AlternatorRegulator/VSR-CAD/AltReg-CAN.jpg

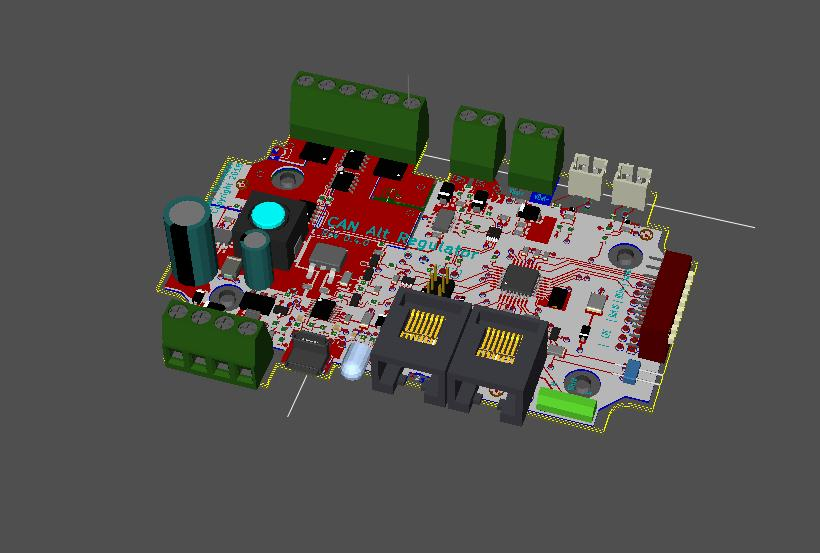
AltReg-CAN.jpg
