AlternatorRegulator/VSR-CAD/Printing Print Schematic.pdf

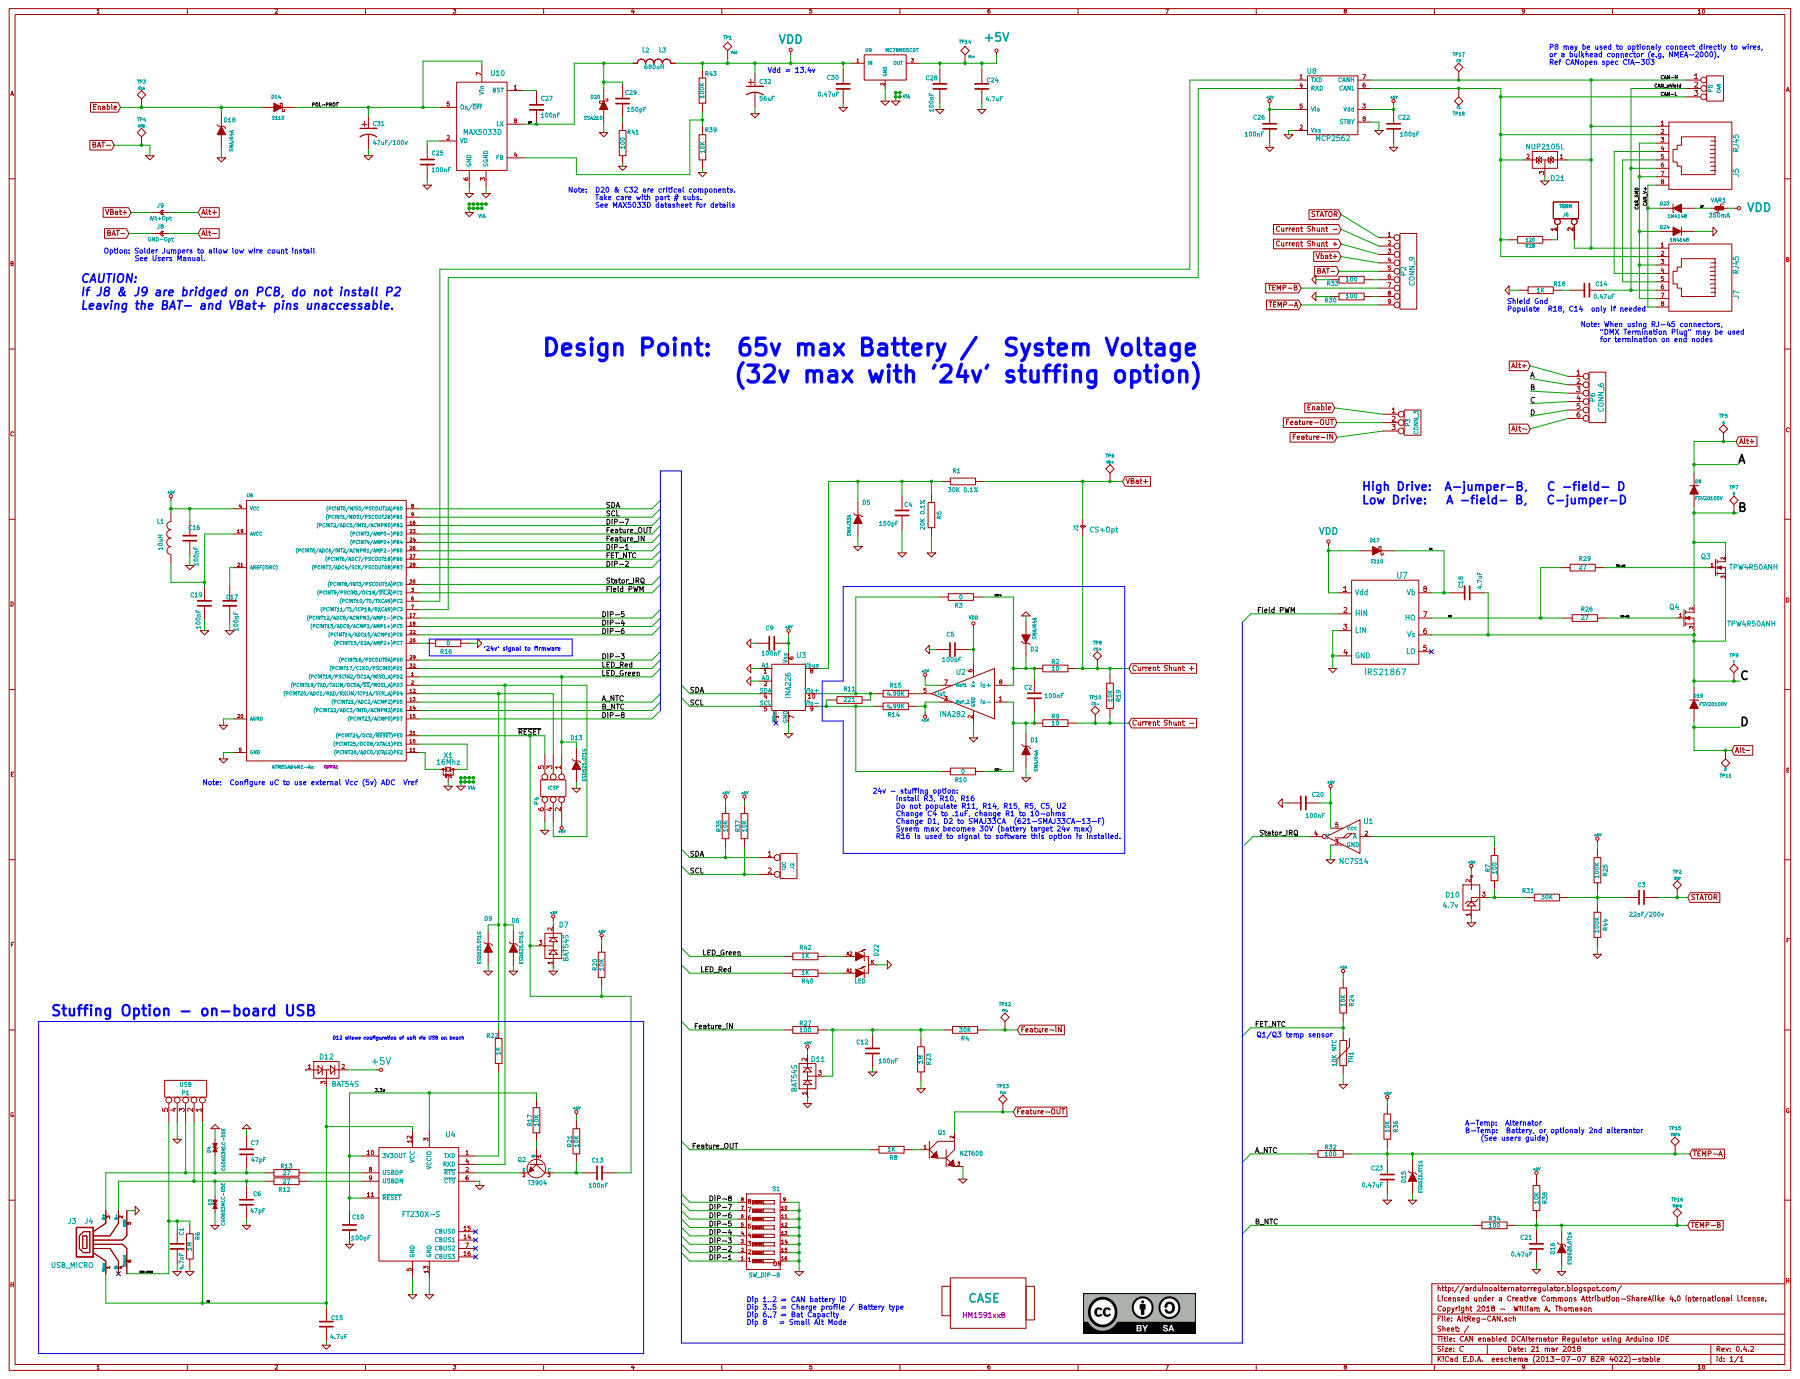
[picture p2: page 1]
