AlternatorRegulator/VSR-CAD/(notices)

Notices in the files:
AltReg-CAN.sch:
Copyright 2018 - William A. Thomason
Licensed under a Creative Commons Attribution-ShareAlike 4.0 International License.
